jinwkim65/auto-guitar-tuner/projectDescription/schematic.pdf

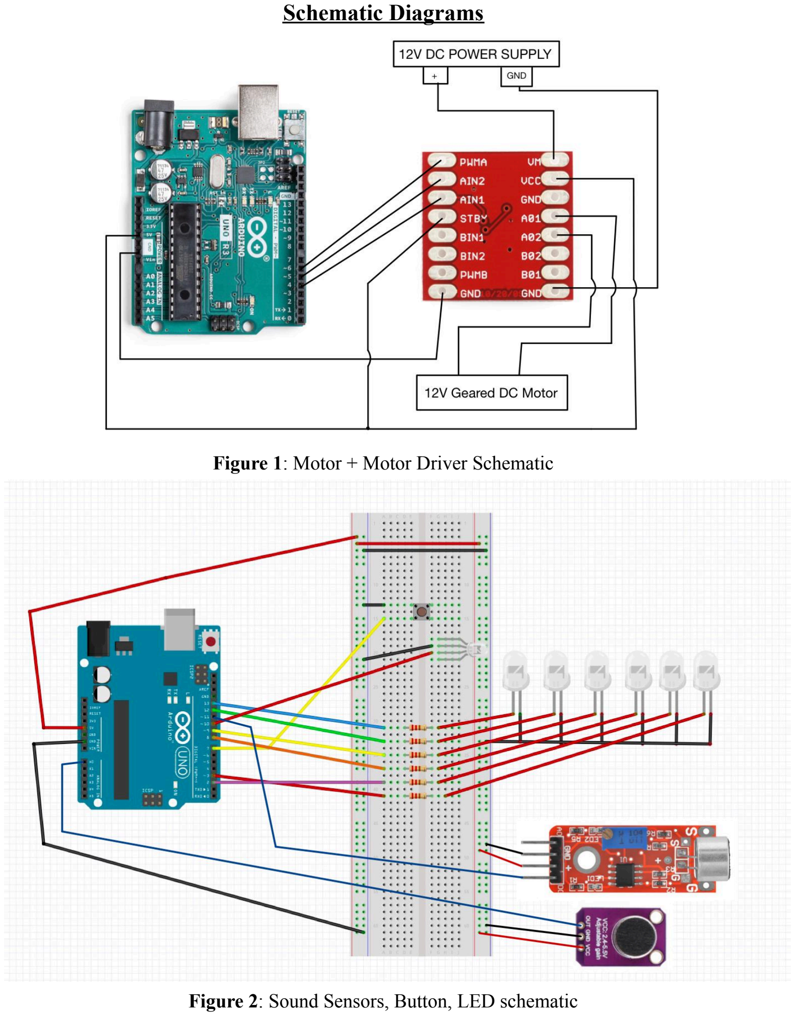
[picture p4: page 1]

Schematic Diagrams

Figure 1: Motor + Motor Driver Schematic

Figure 2: Sound Sensors, Button, LED schematic
